kohrsrh/MaxIQ-HAB-MRGS/docs/HAB_Upgrade_Guide_v3.4.docx

MaxIQ MK10 HAB Flight Station

Firmware & Hardware Upgrade Guide

v3.3 → v3.4

FIRMWARE CHANGE MMC5983MA → TMAG5273 | HARDWARE CHANGE IPP Board → IPB xChips (x2)

Domino4 / MaxIQ Ecosystem • CWV v1-4 (ESP32-WROOM-32)

Arduino IDE • ESP32 Dev Module

SECTION 1 — UPGRADE OVERVIEW

This document covers two simultaneous changes to the MaxIQ MK10 HAB Flight Station:

Change 1: Magnetometer | Replace the SparkFun MMC5983MA with the SparkFun TMAG5273. Both are I2C magnetometers but use different libraries and different data output methods. The firmware must be updated to match.
Change 2: Prototyping Board | Replace the large IPP breadboard with two IPB xBus prototyping boards that integrate into the existing xChip snap-together assembly using the same 6-pin connectors used by all other xChips.

## What Stays the Same

The following are unchanged between v3.3 and v3.4:

- All xChip sensors (IGA, IIA, IWA, IWB, ILB, EL4, INA, ODA)
- All GPIO and I2C pin assignments on the CWV core
- The KX132-1211 accelerometer and its I2C address (0x1F)
- The AS7265x Triad Spectroscopy sensor and its I2C address (0x49)
- The DFRobot SEN0463 Geiger counter on GPIO 43
- The SparkFun OpenLog on Serial2 / GPIO 17
- The CSV data format and all column names except the four Mag columns
- The LoRa packet format and all telemetry fields

## What Changes

Library removed | SparkFun MMC5983MA Arduino Library
Library added | SparkFun TMAG5273 Arduino Library
I2C address | 0x30 (MMC5983MA) → 0x22 (TMAG5273 default)
Mag data method | Raw 18-bit counts + manual conversion → getXData()/getYData()/getZData() returning float mT, then x1000 for uT
CSV column names | Mag_X_uT / Mag_Y_uT / Mag_Z_uT / Mag_Strength_uT → TMAG_X_uT / TMAG_Y_uT / TMAG_Z_uT / TMAG_Strength_uT
Firmware version | v3.3 → v3.4
Physical board | IPP large breadboard (jumper wires) → IPB-A + IPB-B xBus boards (6-pin connectors)

SECTION 2 — FIRMWARE UPDATE

## Part A — Update the Arduino Library

⚠ | Do not install the TMAG5273 library while the MMC5983MA library is still installed. Having both present will not cause a compile error by itself, but removing the old one first keeps your library list clean and avoids confusion.

### Step 1 — Remove the MMC5983MA Library

1. Open Arduino IDE.
2. Go to Sketch > Include Library > Manage Libraries.
3. In the search box, type "MMC5983MA".
4. Click on "SparkFun MMC5983MA Arduino Library" in the results.
5. Click the "Remove" button and confirm when prompted.

### Step 2 — Install the TMAG5273 Library

6. In the Library Manager search box, clear the previous search.
7. Type "TMAG5273".
8. Find "SparkFun TMAG5273 Arduino Library" by SparkFun Electronics.
9. Click "Install".
10. Close the Library Manager.

ℹ | The TMAG5273 library is compatible with all Arduino-supported architectures including ESP32. No additional dependencies are required.

## Part B — Code Changes (v3.3 → v3.4)

The following describes every line that changes. The complete ready-to-upload v3.4 file is provided separately as HAB_FlightStation.ino.

### Change 1 — Replace the #include

Find this line near the top of the file:

#include <SparkFun_MMC5983MA_Arduino_Library.h>

Replace it with:

#include <SparkFun_TMAG5273_Arduino_Library.h>

### Change 2 — Replace the Sensor Object Declaration

Find:

SFE_MMC5983MA magnetometer; // MMC5983MA on IPP

Replace with:

TMAG5273 magnetometer; // TMAG5273 on IPB-A

### Change 3 — Add the TMAG5273 I2C Address Define

After the existing I2C address defines (near the top of the file), add:

#define TMAG5273_ADDR TMAG5273_I2C_ADDRESS_INITIAL // 0x22

ℹ | TMAG5273_I2C_ADDRESS_INITIAL is 0x22. If your specific breakout board has the address pin pulled to a different level, change this value to match. The default SparkFun Qwiic TMAG5273 board uses 0x22.

### Change 4 — Replace the Magnetometer Initialization in setup()

Find the magnetometer initialization block in setup():

// -- MMC5983MA Magnetometer (IPP) --

Serial.print("Magnetometer... ");

if (magnetometer.begin()) {

magnetometer.softReset(); Serial.println("OK"); magOK = true;

} else {

Serial.println("NOT FOUND"); sensorWarning = true;

}

Replace with:

// -- TMAG5273 Magnetometer (IPB-A) --

// begin() returns 1 on success (opposite of most SparkFun libs)

Serial.print("TMAG5273 Mag (IPB-A)... ");

if (magnetometer.begin(TMAG5273_ADDR, Wire) == 1) {

magnetometer.setMagneticChannel(TMAG5273_XYZ_ENABLE);

Serial.println("OK"); magOK = true;

} else {

Serial.println("NOT FOUND"); sensorWarning = true;

}

⚠ | The TMAG5273 begin() function returns 1 for success and 0 for failure — the opposite of many other SparkFun libraries. The comparison must be == 1, not just if (magnetometer.begin()).

### Change 5 — Replace the Magnetometer Reading Block in loop()

Find the magnetometer reading block in loop():

// -- Magnetometer --

float magX = 0, magY = 0, magZ = 0, magStrength = 0;

if (magOK) {

uint32_t magRawX = 0, magRawY = 0, magRawZ = 0;

magnetometer.getMeasurementXYZ(&magRawX, &magRawY, &magRawZ);

magX = ((float)magRawX - 131072.0) / 16384.0 * 100.0;

magY = ((float)magRawY - 131072.0) / 16384.0 * 100.0;

magZ = ((float)magRawZ - 131072.0) / 16384.0 * 100.0;

magStrength = sqrt(magX*magX + magY*magY + magZ*magZ);

}

Replace with:

// -- TMAG5273 Magnetometer --

// getX/Y/Z return float mT; multiply by 1000 to convert to uT

float magX = 0, magY = 0, magZ = 0, magStrength = 0;

if (magOK) {

magX = magnetometer.getXData() * 1000.0;

magY = magnetometer.getYData() * 1000.0;

magZ = magnetometer.getZData() * 1000.0;

magStrength = sqrt(magX*magX + magY*magY + magZ*magZ);

}

ℹ | The x1000 conversion preserves the uT unit scale used in the CSV columns and LoRa packet. The TMAG5273 outputs milliTesla (mT) natively; Earth's magnetic field is approximately 25-65 uT, or 0.025-0.065 mT, so expect values in the low single digits of mT or tenths of mT.

### Change 6 — Update the CSV Header in setup()

Find the four magnetometer column names in the OpenLog CSV header:

"Mag_X_uT,Mag_Y_uT,Mag_Z_uT,Mag_Strength_uT,"

Replace with:

"TMAG_X_uT,TMAG_Y_uT,TMAG_Z_uT,TMAG_Strength_uT,"

ℹ | This is a cosmetic label change only. The column position and unit (uT) are identical. Any spreadsheet templates that reference these columns by name will need to be updated.

## Part C — Upload the Firmware

⚠ | Always unsnap all xChips except the PPU programmer and the CWV core before uploading. Remove the microSD card from the OpenLog as well. Uploading with xChips attached can cause upload failures or lock the bootloader.

### Arduino IDE Settings — CWV v1-4 (ESP32-WROOM-32)

Board | ESP32 Dev Module
Upload Speed | 460800 (max with PPU)
PSRAM | QSPI PSRAM
Port | Select the COM port for your PPU

11. Unsnap all xChips from the assembly. Leave only the PPU and the CWV.
12. Remove the microSD card from the SparkFun OpenLog.
13. Connect the PPU to your computer via USB-A.
14. Open HAB_FlightStation.ino (v3.4) in Arduino IDE.
15. Set the board: Tools > Board > esp32 > ESP32 Dev Module
16. Set the upload speed: Tools > Upload Speed > 460800
17. Select the correct COM port: Tools > Port > (your PPU port)
18. Click Upload. Watch the output panel until you see: Hash of data verified.
19. Open the Serial Monitor (Tools > Serial Monitor) at 115200 baud.
20. Press the reset button on the CWV. Verify the startup messages show TMAG5273 in the magnetometer line.

ℹ | Expected startup output for the magnetometer line: "TMAG5273 Mag (IPB-A)... OK" if the sensor is connected, or "TMAG5273 Mag (IPB-A)... NOT FOUND" if it is not yet wired up. Either result confirms the v3.4 firmware is running correctly.

SECTION 3 — HARDWARE: IPP → IPB xBus BOARDS

## Overview of the IPB xBus Prototyping Board

The IPB (Integrated Prototyping Board) is a small square xChip-format board that connects to the Domino4 xBus backplane using the same 6-pin connectors used by every other xChip in the assembly. Unlike the large IPP breadboard, which connected via jumper wires, the IPB snaps directly into the chain.

Each IPB board has eight labeled signal rows running vertically down the center of the board: VCC, SDA, SCL, VSRC, IO, TXD, RXD, and GND. Each row has three through-holes arranged in a horizontal line across the board:

Left two holes | Both holes are the same net — electrically identical. These are your working solder points for connecting sensor wires. Use one hole per sensor wire. If two sensors share the same signal (e.g. both need VCC), use one left hole for each.
Right single hole | This hole routes to the right-side xBus edge connector and is reserved for xBus backplane pass-through. Do not use this hole for sensor wires.

Signal reference for each labeled row:

VCC | 3.3V regulated power from the xBus backplane
SDA | I2C data line — shared with all other I2C xChips in the assembly
SCL | I2C clock line — shared with all other I2C xChips in the assembly
VSRC | Raw (unregulated) voltage source from the battery, before the onboard regulator
IO | General-purpose GPIO pin — used here for the Geiger counter interrupt signal
TXD | UART transmit — used here for the OpenLog serial data line
RXD | UART receive — not used in this application
GND | Ground

ℹ | When the wiring tables in this guide say 'VCC pad', 'GND pad', 'SDA pad', etc., they always mean one of the two left-column holes in that labeled row. Never solder sensor wires to the single right-column hole.

## Board Assignment

Two IPB boards are used in this upgrade, referred to as IPB-A and IPB-B:

IPB-A (I2C sensors + Geiger) | KX132-1211 Accelerometer TMAG5273 Magnetometer AS7265x Triad Spectroscopy Geiger counter signal wire
IPB-B (OpenLog UART) | SparkFun OpenLog

ℹ | The KX132, TMAG5273, and AS7265x all communicate via I2C and share the SDA and SCL lines on IPB-A. The Geiger counter uses a separate signal wire to the IO pad. The OpenLog gets its own board (IPB-B) because it uses UART, not I2C, and keeping UART and I2C traffic physically separated on their own boards makes troubleshooting easier.

## Part A — Prepare the Sensor Breakout Boards

⚠ | Before soldering, verify the I2C address of each sensor. If two sensors share an address, one must be configured to use an alternate address using its address selection pin or solder jumper. The three I2C sensors here have distinct default addresses and will not conflict.

### I2C Address Reference

Sensor | Default I2C Address
KX132-1211 | 0x1F (default, ADDR pin floating or low)
TMAG5273 | 0x22 (default, TMAG5273_I2C_ADDRESS_INITIAL)
AS7265x Triad | 0x49 (fixed, cannot be changed)

### Step 1 — Solder Headers or Pads on the Sensor Breakout Boards

21. If your KX132, TMAG5273, and AS7265x breakouts do not have header pins installed, solder male or female 0.1-inch headers to all used pins on each board.
22. Verify each board powers on and is detected via I2C before soldering to the IPB (use an I2C scanner sketch if needed).

### Step 2 — Prepare the IPB Boards

23. Obtain two IPB xBus prototyping boards.
24. Orient each IPB so the signal labels (VCC, SDA, SCL, VSRC, IO, TXD, RXD, GND) are readable. Each row has two holes on the left side and one hole on the right. All sensor wires go into the left-side holes only.
25. Test-fit the sensors on IPB-A to plan wire routing before soldering.

## Part B — Wire the Sensors to IPB-A

All three I2C sensors on IPB-A share the same four signal rows: VCC, SDA, SCL, and GND. Because each row has two left-column holes and three sensors share each signal, you will use both left holes in the VCC, SDA, SCL, and GND rows — one hole per sensor for two of the three sensors, then bridge the third sensor’s wire to the same pad with a short jumper or use a small piece of hookup wire soldered to span from one hole to the sensor. The Geiger signal wire uses the single left hole in the IO row.

ℹ | Practical approach: solder the KX132 and TMAG5273 wires directly into the two left holes of each shared row (VCC, SDA, SCL, GND). For the AS7265x, run short wires that join to the same solder joints, or add a small three-way splice at each pad. All three sensors are electrically on the same bus regardless of which approach you use.

### KX132-1211 Accelerometer → IPB-A

KX132 Pin | IPB-A Hole | Signal | Notes
VCC (3.3V) | VCC row — left hole 1 | Power | 3.3V from xBus
GND | GND row — left hole 1 | Ground
SDA | SDA row — left hole 1 | I2C Data | Shared with TMAG5273 and AS7265x
SCL | SCL row — left hole 1 | I2C Clock | Shared with TMAG5273 and AS7265x

### TMAG5273 Magnetometer → IPB-A

TMAG5273 Pin | IPB-A Hole | Signal | Notes
VCC (3.3V) | VCC row — left hole 2 | Power | 3.3V from xBus. Never use the VSRC row — unregulated voltage will damage this sensor
GND | GND row — left hole 2 | Ground
SDA | SDA row — left hole 2 | I2C Data | Shared with KX132 and AS7265x
SCL | SCL row — left hole 2 | I2C Clock | Shared with KX132 and AS7265x

### AS7265x Triad Spectroscopy → IPB-A

AS7265x Pin | IPB-A Hole | Signal | Notes
VCC (3.3V) | VCC row — splice to either left hole | Power | Both left holes are occupied; bridge to either solder joint with a short wire
GND | GND row — splice to either left hole | Ground | Same approach as VCC
SDA | SDA row — splice to either left hole | I2C Data | Same approach as VCC
SCL | SCL row — splice to either left hole | I2C Clock | Same approach as VCC

ℹ | For the AS7265x wires, the simplest approach is to tin the wire end and solder it directly onto the top of the existing solder joint at either left hole in each row. This creates a solid three-way junction at each pad without needing additional hardware.

### Geiger Counter Signal → IPB-A

Geiger Pin | IPB-A Hole | Signal | Notes
Signal/OUT | IO row — left hole 1 | GPIO 43 interrupt | Falling-edge interrupt in firmware
VCC | VCC row — splice to either left hole | Power | Confirm Geiger module accepts 3.3V; if it requires 5V use the VSRC row instead
GND | GND row — splice to either left hole | Ground

⚠ | The DFRobot SEN0463 Geiger counter may require 5V power depending on version. If so, connect its VCC to the VSRC row left hole rather than the VCC row, but keep the signal wire on the IO row as-is. The IO row on the CWV is 3.3V logic. If the Geiger signal output is 5V, add a voltage divider on the signal line before the IO hole.

## Part C — Wire the OpenLog to IPB-B

The SparkFun OpenLog only needs three connections: power, ground, and the serial data line from the CWV. Only one sensor connects to IPB-B, so each signal row needs only one hole.

### SparkFun OpenLog → IPB-B

OpenLog Pin | IPB-B Hole | Signal | Notes
VCC (3.3V) | VCC row — left hole 1 | Power | OpenLog operates on 3.3V
GND | GND row — left hole 1 | Ground
RXI | TXD row — left hole 1 | UART TX from CWV | CWV Serial2 TX is GPIO 17; the TXD row carries this signal
TXO | (not connected) | — | OpenLog TX not used; firmware does not read from OpenLog

ℹ | The OpenLog's RXI pin (its receive input) connects to the TXD row on IPB-B, which carries the CWV's transmit signal. This is correct: the CWV transmits data, the OpenLog receives and logs it. The label TXD on the IPB refers to the signal direction from the CWV's perspective, not the OpenLog's.

## Part D — Integrate the IPB Boards into the xChip Assembly

The IPB boards connect to the Domino4 xBus backplane using the same 6-pin edge connectors used by all other xChips. They can be placed anywhere in the xChip chain that is convenient for cable routing.

⚠ | Fully power down the assembly (remove the 18650 battery from the PLA xChip) before connecting or disconnecting any IPB boards from the xBus chain. The xBus carries live power when the battery is installed.

### Step 1 — Power Down

26. Remove the 18650 battery from the PLA xChip.
27. Disconnect the USB cable from the PPU if connected.

### Step 2 — Disassemble the Old IPP Configuration

28. Unplug all jumper wires from the IPP prototyping board.
29. Remove the IPP board from the assembly.
30. Gently remove the KX132, TMAG5273 (or MMC5983MA if still installed), AS7265x, and OpenLog from the IPP board.

### Step 3 — Connect IPB-A to the xChip Assembly

31. Select a position in the xChip chain for IPB-A. A position near the end of the chain is recommended so the sensor wires can route outward without crossing other boards.
32. Align the 6-pin connector on IPB-A with the corresponding connector on the adjacent xChip.
33. Press firmly and evenly until the connector is fully seated. You will feel a positive click when properly engaged.
34. Verify the board is flush and level with the adjacent xChips.

### Step 4 — Connect IPB-B to the xChip Assembly

35. Select a position for IPB-B, ideally adjacent to IPB-A or at the end of the chain.
36. Connect IPB-B to the xChip chain the same way as IPB-A.

### Step 5 — Reinstall Sensors and Verify Wiring

37. Mount the KX132, TMAG5273, and AS7265x on or near IPB-A. Use standoffs, foam adhesive, or Velcro to secure the breakout boards to the assembly frame so they cannot shift during flight.
38. Mount the OpenLog on or near IPB-B.
39. Connect all sensor wires to IPB-A per the tables in Part B.
40. Connect the OpenLog to IPB-B per the table in Part C.
41. Insert a freshly formatted microSD card into the OpenLog.
42. Double-check all wiring with the tables before applying power.

## Part E — Power-On Verification

⚠ | Do not attempt to upload new firmware once the xChips are reassembled. If you need to upload, unsnap all xChips first (leave only PPU and CWV), upload, then reassemble.

43. Reinstall the 18650 battery.
44. Open Arduino IDE and set the Serial Monitor to 115200 baud.
45. Observe the startup messages. Expected output for a fully connected assembly:

=== HAB Flight Station v3.4 Starting ===

LoRa... OK

GPS INA... OK - HAB mode enabled

IGA VOC... OK

IIA Accel... OK

IWA Temp/Hum... OK

IWB Baro... OK

KX132 Accel (IPB-A)... OK

TMAG5273 Mag (IPB-A)... OK

Triad Spectro (IPB-A)... OK

Geiger OK pin 43 (IO pad on IPB-A)

CSV header sent to OpenLog

=== Setup Complete ===

46. Verify the Neopixel status LED shows GREEN (all systems OK) or YELLOW (sensor warning, check serial output for which sensor was not found).
47. Allow the system to run through at least one 30-second TX cycle. Verify a data row appears on the OpenLog microSD.

SECTION 4 — TROUBLESHOOTING

TMAG5273 shows NOT FOUND | 1. Verify SDA, SCL, VCC, and GND are connected to IPB-A. 2. Confirm I2C address: run an I2C scanner sketch with only the TMAG5273 connected. Expected address: 0x22. 3. If the address is different, update the TMAG5273_ADDR define in the firmware. 4. Confirm the VCC wire goes to the VCC pad (3.3V), not VSRC.
Compile error: 'TMAG5273' not declared | The TMAG5273 library is not installed. Open Library Manager (Sketch > Include Library > Manage Libraries), search for TMAG5273, and install SparkFun TMAG5273 Arduino Library.
Compile error: 'SFE_MMC5983MA' not declared | The include line still references the old MMC5983MA library. Verify Change 1 and Change 2 were applied. The old library may also be missing; that is expected and not an error.
Mag values are very small (near zero) | Normal range for Earth's field is approximately 25-65 uT. If values are near zero, check that setMagneticChannel(TMAG5273_XYZ_ENABLE) is being called in the initialization block.
IPB board not detected / sensors not found after assembly | 1. Verify the 6-pin xBus connector is fully seated on both sides. 2. Power down, reseat the connector, and power back up. 3. Check that VCC and GND wires from the sensor reach the correct IPB pads.
OpenLog not logging / blank CSV | 1. Verify the OpenLog RXI pin connects to the IPB-B TXD pad. 2. Confirm the microSD card is inserted and freshly FAT32 formatted. 3. The OpenLog green LED should blink rapidly when receiving data.
Neopixel shows YELLOW after upgrade | One or more sensors was not found during startup. Open the Serial Monitor at 115200 baud and reset the board. Read the startup messages to identify which sensor returned NOT FOUND.

SECTION 5 — QUICK REFERENCE TABLES

## Complete Sensor List — v3.4

IGA xChip | SGP30 VOC / CO2 — I2C 0x58
IIA xChip | LIS2DH12 Accelerometer — I2C 0x19
IWA xChip | SHT31 Temperature / Humidity — I2C 0x44
IWB xChip | SPL06 Barometer — I2C 0x77
ILB xChip | Ambient Light — I2C 0x53
EL4 xChip | SX1278 LoRa 433 MHz — SPI
INA xChip | Quectel L76-L GPS — I2C 0x10
ODA xChip | SSD1306 OLED 128x64 — I2C 0x3C
IPB-A: KX132-1211 | High-g Accelerometer ±16g — I2C 0x1F
IPB-A: TMAG5273 ★ NEW | 3D Hall-Effect Magnetometer — I2C 0x22 (default)
IPB-A: AS7265x Triad | 18-Channel UV/Vis/NIR Spectroscopy — I2C 0x49
IPB-A: Geiger SEN0463 | Ionizing Radiation — GPIO 43 (IO pad)
IPB-B: OpenLog | CSV Data Logger to microSD — Serial2 GPIO 17 (TXD pad)

## Library List — v3.4

Library Name | Author / Used For
RadioLib | Jan Gromes — LoRa EL4 xChip
SparkFun SGP30 Arduino Library | SparkFun — IGA xChip
SparkFun LIS2DH12 Arduino Library | SparkFun — IIA xChip
Adafruit SHT31 Library | Adafruit (Install All) — IWA xChip
SPL06-007 (ZIP install) | rv701 on GitHub — IWB xChip
SparkFun KX13X Arduino Library | SparkFun — KX132 on IPB-A
SparkFun TMAG5273 Arduino Library | SparkFun — TMAG5273 on IPB-A ★ NEW
SparkFun AS7265X Arduino Library | SparkFun — AS7265x on IPB-A
Adafruit GPS Library | Adafruit — INA xChip GPS
Freenove WS2812 Lib for ESP32 | Freenove — Neopixel status LED
SSD1306Ascii | greiman — ODA OLED display
