kohrsrh/MaxIQ-HAB-MRGS/docs/HAB_Complete_Guide_v4.docx

MaxIQ MK10 HAB Flight Station

Complete Build Guide & Task List

Firmware v3.1 | Domino4 CWV (ESP32-WROOM-32) | Updated with OLED & jumper wire guidance

# 1. Parts to Order

## Must Order

Part | SparkFun SKU | Notes
SparkFun Accelerometer Breakout - KX132-1211 (Qwiic) | SEN-17871 | Already in cart - keep it
SparkFun Triple Axis Magnetometer - MMC5983MA (Qwiic) | SEN-19895 | Add to cart

NOTE: The NEO-M9N GPS breakout is NOT needed - you have the INA xChip which snaps directly onto the CWV. Remove it from your cart if added.

## Already Have - Confirmed

Item | Status | Notes
INA xChip (GPS - Quectel L76) | Confirmed in collection | Snaps onto xBus, no wiring needed
ODA xChip (OLED 128x64) | Confirmed working | Snaps onto xBus, displays live data
SparkFun OpenLog | On hand | Wires to IPP via jumper wires
AS7265x Triad Spectroscopy | On hand | Wires to IPP via jumper wires
DFRobot SEN0463 Geiger Counter | On hand | Wires to IPP via jumper wires
IPP Expansion Board | On hand | Main breadboard for all wired components
18650 xChip (PLA) | On hand | Powers all electronics

# 2. Arduino IDE Libraries

Go to Sketch > Include Library > Manage Libraries. Search and install each:

# | Library Name | Author | Status

1 | RadioLib | Jan Gromes | Already installed
2 | SparkFun SGP30 Arduino Library | SparkFun | Already installed
3 | SparkFun LIS2DH12 Arduino Library | SparkFun | Already installed
4 | Adafruit SHT31 Library | Adafruit | Already installed - click Install All
5 | SparkFun KX13X Arduino Library | SparkFun | Already installed
6 | SparkFun MMC5983MA Arduino Library | SparkFun | Already installed
7 | SparkFun AS7265X Arduino Library | SparkFun | Already installed
8 | Adafruit GPS Library | Adafruit | Already installed - for INA xChip
9 | Freenove WS2812 Lib for ESP32 | Freenove | Already installed
10 | SSD1306Ascii | greiman | Already installed - for ODA OLED

Manual ZIP install (Sketch > Include Library > Add .ZIP Library):

- SPL06-007: https://github.com/rv701/SPL06-007 (already installed)

# 3. Uploading Firmware

WARNING: Always strip to PPU + CWV only when uploading. Remove all other xChips before upload or it will fail.

1. Unsnap all xChips except PPU and CWV
2. Open HAB_FlightStation.ino (v3.1) in Arduino IDE
3. Tools > Board > esp32 > ESP32 Dev Module
4. Tools > Port > COM7
5. Click Upload - wait for 'Hash of data verified'
6. Snap all xChips back on
7. Plug in USB - watch OLED and Neopixel

NOTE: If upload fails with 'No serial data received', unplug USB, wait 10 seconds, replug and immediately click Upload.

# 4. IPP Wiring Guide

The IPP board snaps into the Domino4 xBus. It has dedicated bus rails along all four edges. You will be using standard breadboard jumper wires for all connections - no soldering required at this stage.

## Understanding Jumper Wires

Breadboard jumper wires come in three types:

- Male-to-Male (M-M): pin on both ends. Use for connecting two breadboard holes.
- Male-to-Female (M-F): pin on one end, socket on other. Use when connecting to a header pin on a breakout board.
- Female-to-Female (F-F): socket on both ends. Rarely needed for this build.

NOTE: For connecting SparkFun breakout boards to the IPP rails, you will typically use Male-to-Male jumper wires since both the breakout board headers and IPP holes accept male pins.

## Understanding the IPP Rails

Look at the IPP board. Along the top and bottom edges you will see labeled rows of holes:

- GND — Ground (negative). Connect all GND pins here. Use black wires by convention.
- VCC — 3.3V power. Connect all VCC/3V3 pins here. Use red wires by convention.
- SDA — I2C data. Connect all SDA pins from breakout boards here.
- SCL — I2C clock. Connect all SCL pins from breakout boards here.
- TXD — Serial transmit (GPIO 17). OpenLog RXI connects here.

NOTE: Every hole in a labeled rail row is connected together. GND at the far left is the same as GND at the far right. Connect to whichever hole is closest to your component.

## Wiring Table - All Breakout Boards

Component | Component Pin | Connect To | Wire Color | Notes
SparkFun OpenLog | VCC | VCC rail | Red | 3.3V only - critical!
SparkFun OpenLog | GND | GND rail | Black
SparkFun OpenLog | RXI | TXD pin (GPIO 17) | Any | Data from ESP32 to OpenLog
SparkFun OpenLog | TXO | Leave unconnected | - | Not needed
SparkFun OpenLog | GRN | Leave unconnected | - | Not needed
SparkFun OpenLog | BLK | Leave unconnected | - | Not needed
KX132 Accel | VCC / 3V3 | VCC rail | Red
KX132 Accel | GND | GND rail | Black
KX132 Accel | SDA | SDA rail | Blue
KX132 Accel | SCL | SCL rail | Yellow
MMC5983MA Mag | VCC / 3V3 | VCC rail | Red
MMC5983MA Mag | GND | GND rail | Black
MMC5983MA Mag | SDA | SDA rail | Blue
MMC5983MA Mag | SCL | SCL rail | Yellow
AS7265x Triad | VCC / 3V3 | VCC rail | Red
AS7265x Triad | GND | GND rail | Black
AS7265x Triad | SDA | SDA rail | Blue
AS7265x Triad | SCL | SCL rail | Yellow
DFRobot Geiger | VCC | VCC rail | Red | 3.3V - do not use 5V
DFRobot Geiger | GND | GND rail | Black
DFRobot Geiger | SIG | GPIO 43 hole in grid | Any | Pulse signal to ESP32

NOTE: Color coding is a convention to help you stay organized, not a requirement. However using red for VCC and black for GND consistently will prevent accidentally swapping power and ground which can damage components.

## Step-by-Step Wiring Instructions

Before You Start

1. Unplug USB - never wire with power connected
2. Snap the IPP onto the CWV xBus connector
3. Lay out all breakout boards and jumper wires on your desk
4. Identify the VCC, GND, SDA, SCL pins on each breakout board - check the silkscreen labels on the board

Wire OpenLog First (Most Important)

1. Place OpenLog on the IPP center grid or nearby
2. Run red wire from OpenLog VCC to any VCC rail hole
3. Run black wire from OpenLog GND to any GND rail hole
4. Run a wire from OpenLog RXI to the TXD labeled hole on the IPP left side
5. Leave TXO, GRN, BLK pins unconnected
6. Insert FAT32 microSD card into OpenLog slot
7. Power on - OpenLog green LED should blink then go solid
8. Wait 2 minutes, power off, check SD card for LOG file with CSV data

Wire Each I2C Sensor (Same Pattern for All)

1. Place breakout board on IPP center grid
2. Red wire: board VCC/3V3 pin → VCC rail
3. Black wire: board GND pin → GND rail
4. Blue wire: board SDA pin → SDA rail
5. Yellow wire: board SCL pin → SCL rail
6. Power on and check Neopixel - yellow means still missing sensors, green means all found
7. Repeat for next sensor

Wire Geiger Counter

1. Red wire: Geiger VCC → VCC rail
2. Black wire: Geiger GND → GND rail
3. Wire: Geiger SIG → GPIO 43 hole in center grid

Verify Before Each Power-On

- VCC (red) goes to VCC rail - not GND rail
- GND (black) goes to GND rail - not VCC rail
- SDA and SCL not swapped
- OpenLog RXI goes to TXD, not SDA or SCL
- No bare wire ends touching each other

# 5. xChip Snap-On Assembly

These chips require no wiring - they snap directly onto the CWV xBus connector. Order does not matter electrically but keep the stack manageable.

xChip | Function | Notes
EL4 | LoRa 433MHz transmitter | Must be snapped on for telemetry
IGA | SGP30 VOC/CO2 sensor | Needs ~15 sec warmup after power-on
IIA | LIS2DH12 accelerometer | Redundant with KX132 on IPP
IWA | SHT31 temp/humidity | Most reliable temp sensor in stack
IWB | SPL06 barometer | Cross-check altitude with GPS
ILB | Light sensor | Ambient light level
INA | Quectel L76 GPS | HAB mode auto-enabled at startup
ODA | SSD1306 OLED display | Shows live sensor data, cycles every 5 sec
PLA | 18650 battery | Powers all electronics

# 6. OLED Display Guide

The ODA xChip OLED display shows live sensor data and cycles through 4 pages every 5 seconds automatically.

Page | Content | Use For
1 - Environment | Temperature, Humidity, Pressure | Confirming environmental sensors work
2 - GPS | Lat/Lon, Altitude, Satellites, Fix status | Pre-flight GPS lock confirmation
3 - Air/Radiation | Geiger CPM, TVOC ppb, CO2 ppm | Confirming radiation/air sensors work
4 - System | Packet count, LoRa status, Uptime | Overall system health check

## Startup Sequence on OLED

- 'HAB Station v3.1' + 'Initializing...' shown during boot
- Status screen shows LoRa OK/FAIL, GPS OK/NOT FOUND, Sensors OK/CHECK
- Flight pages begin cycling after setup completes

NOTE: Values will show zero for the first 30-35 seconds after power-on. This is normal - the first sensor reading cycle takes time to complete.

# 7. Neopixel Status Codes

Color | Meaning | Action
BLUE (solid) | Starting up | Wait - normal
GREEN (solid) | All systems OK | Ready to fly
YELLOW (solid) | One or more sensors not found | Check wiring of missing sensor
RED (solid) | LoRa failed | Check EL4 xChip seating
PURPLE (solid) | GPS not found | Check INA xChip seating

# 8. Complete Sensor Manifest

Sensor | Location | Measures | I2C Addr
IGA - SGP30 | xChip | VOC, estimated CO2 | 0x58
IIA - LIS2DH12 | xChip | Acceleration (low-g precision) | 0x19
IWA - SHT31 | xChip | Temperature, Humidity | 0x44
IWB - SPL06 | xChip | Barometric Pressure | 0x77
ILB - Light | xChip | Ambient light (lux) | 0x53
INA - Quectel L76 | xChip | GPS Position, Altitude, Speed (80km limit) | 0x10
ODA - SSD1306 | xChip | OLED display - live sensor readout | 0x3C
KX132-1211 | IPP jumper wires | Acceleration up to 16g | 0x1F
MMC5983MA | IPP jumper wires | Magnetic field strength + direction | 0x30
AS7265x Triad | IPP jumper wires | Full spectrum UV/Vis/NIR 18 channels | 0x49
DFRobot SEN0463 | IPP jumper wires | Ionizing radiation CPM | GPIO 43
SparkFun OpenLog | IPP jumper wires | Data logger - writes CSV to microSD | Serial2
EL4 SX1278 | xChip | LoRa 433MHz telemetry to TinyGS | SPI

# 9. Power Budget

Component | Current | Notes
ESP32 (CWV) | ~80 mA
LoRa TX peak | ~120 mA | Only during 30-sec transmission burst
All xChip sensors | ~30 mA | Combined
KX132 | ~1 mA
MMC5983MA | ~2 mA
AS7265x Triad | ~5 mA | Passive mode, LEDs disabled
OpenLog | ~20 mA
Geiger SEN0463 | ~20 mA
GPS INA | ~25 mA
OLED ODA | ~10 mA
Neopixel | ~15 mA | At 40/255 brightness
TOTAL PEAK | ~328 mA | Well within 18650 capacity
Runtime (3000mAh cell) | ~9 hours | More than enough for 4hr flight

Power circuit 1 (18650 xChip PLA): All electronics above. Power circuit 2 (USB power bank 10,000+ mAh): Insta360 One X2 camera + 5V heating pad.

# 10. Known Issues & Status

Issue | Status | Notes
Serial monitor garbage output | Unresolved | Not needed - OpenLog handles all logging
Built-in CWV SD card slot | Abandoned | Replaced by SparkFun OpenLog on IPP
OLED page not cycling | Under investigation | Values show zero first 30sec - normal
KX132 arriving by mail | Ordered | Wire to IPP when received
MMC5983MA arriving by mail | Ordered | Wire to IPP when received
LoRa frequency | Pending test | Confirm 433.775 MHz matches TinyGS ground station
GPS HAB mode | Auto-enabled | Sent at every startup via $PMTK886,3 command
OpenLog data logging | Ready to test | Wire and test before flight
